braingram/Lapse-O-Matic/Lapse-O-Matic_HARDWARE/tube_trap/beambreak_brackets.stl

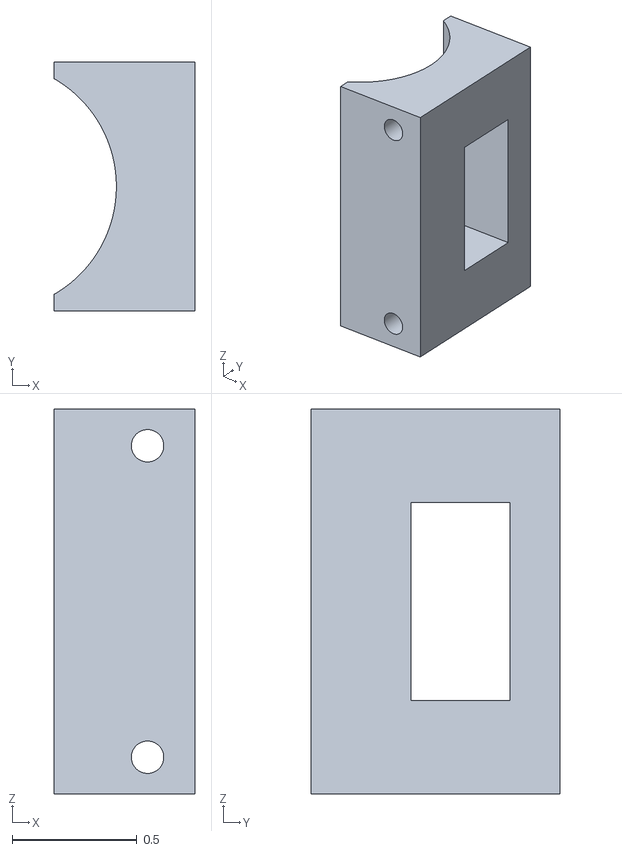
[picture p1: CAD file, 2023-06-22]
Lapse-O-Matic_HARDWARE/tube_trap/beambreak_brackets.stl
0.565 x 1.00 x 1.55
