braingram/Lapse-O-Matic/Lapse-O-Matic_PCB/Lapse_O_Matic_PCB.pdf

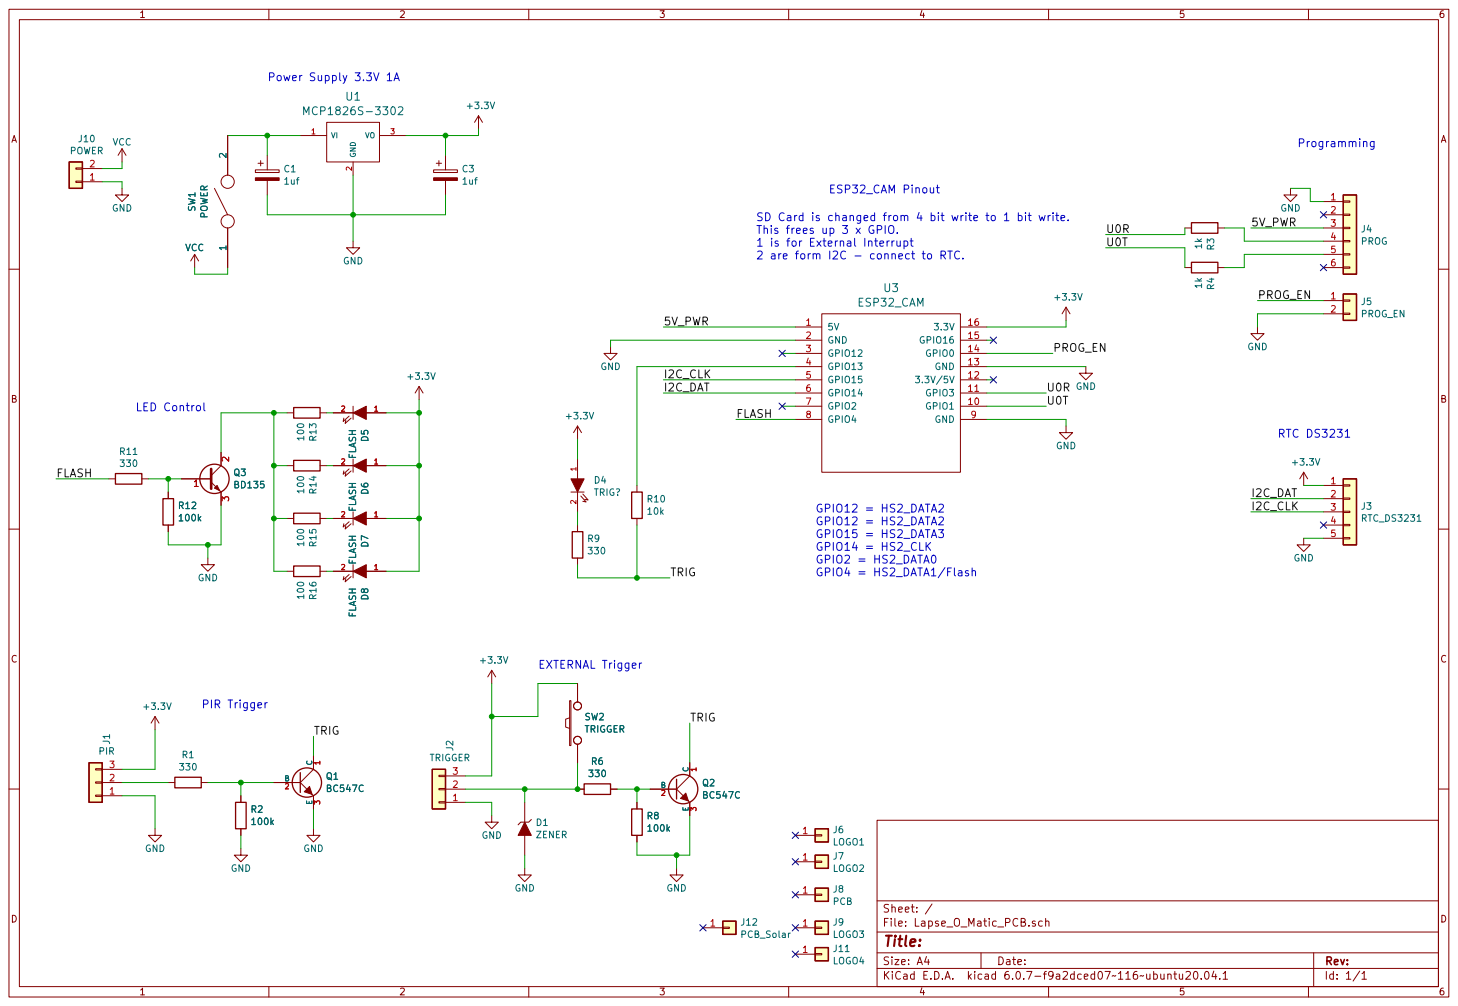
[picture p2: page 1]

I2C_CLK U0T SD Card is changed from 4 bit write to 1 bit write.
This frees up 3 x GPIO.
1 is for External Interrupt
2 are form I2C - connect to RTC.

I2C_CLK
I2C_DAT
