braingram/Lapse-O-Matic/Lapse-O-Matic_FIRMWARE/BJG_Lapse/camera_pins.h

#if defined(CAMERA_MODEL_WROVER_KIT)
#define CAM_PIN_PWDN    -1
#define CAM_PIN_RESET   -1
#define CAM_PIN_XCLK    21
#define CAM_PIN_SIOD    26
#define CAM_PIN_SIOC    27
#define CAM_PIN_D7      35
#define CAM_PIN_D6      34
#define CAM_PIN_D5      39
#define CAM_PIN_D4      36
#define CAM_PIN_D3      19
#define CAM_PIN_D2      18
#define CAM_PIN_D1       5
#define CAM_PIN_D0       4
#define CAM_PIN_VSYNC   25
#define CAM_PIN_HREF    23
#define CAM_PIN_PCLK    22


#elif defined(CAMERA_MODEL_ESP_EYE)
#define PWDN_GPIO_NUM    -1
#define RESET_GPIO_NUM   -1
#define XCLK_GPIO_NUM    4
#define SIOD_GPIO_NUM    18
#define SIOC_GPIO_NUM    23

#define Y9_GPIO_NUM      36
#define Y8_GPIO_NUM      37
#define Y7_GPIO_NUM      38
#define Y6_GPIO_NUM      39
#define Y5_GPIO_NUM      35
#define Y4_GPIO_NUM      14
#define Y3_GPIO_NUM      13
#define Y2_GPIO_NUM      34
#define VSYNC_GPIO_NUM   5
#define HREF_GPIO_NUM    27
#define PCLK_GPIO_NUM    25

#elif defined(CAMERA_MODEL_M5STACK_PSRAM)
#define PWDN_GPIO_NUM     -1
#define RESET_GPIO_NUM    15
#define XCLK_GPIO_NUM     27
#define SIOD_GPIO_NUM     25
#define SIOC_GPIO_NUM     23

#define Y9_GPIO_NUM       19
#define Y8_GPIO_NUM       36
#define Y7_GPIO_NUM       18
#define Y6_GPIO_NUM       39
#define Y5_GPIO_NUM        5
#define Y4_GPIO_NUM       34
#define Y3_GPIO_NUM       35
#define Y2_GPIO_NUM       32
#define VSYNC_GPIO_NUM    22
#define HREF_GPIO_NUM     26
#define PCLK_GPIO_NUM     21

#elif defined(CAMERA_MODEL_M5STACK_WIDE)
#define PWDN_GPIO_NUM     -1
#define RESET_GPIO_NUM    15
#define XCLK_GPIO_NUM     27
#define SIOD_GPIO_NUM     22
#define SIOC_GPIO_NUM     23

#define Y9_GPIO_NUM       19
#define Y8_GPIO_NUM       36
#define Y7_GPIO_NUM       18
#define Y6_GPIO_NUM       39
#define Y5_GPIO_NUM        5
#define Y4_GPIO_NUM       34
#define Y3_GPIO_NUM       35
#define Y2_GPIO_NUM       32
#define VSYNC_GPIO_NUM    25
#define HREF_GPIO_NUM     26
#define PCLK_GPIO_NUM     21

#elif defined(CAMERA_MODEL_AI_THINKER)
// The following defines are for the ESP32-Cam AI-THINKER module only. I haven't tried any others.
#define CAM_PIN_PWDN    32
#define CAM_PIN_RESET   -1
#define CAM_PIN_XCLK    0
#define CAM_PIN_SIOD    26
#define CAM_PIN_SIOC    27
#define CAM_PIN_D7      35
#define CAM_PIN_D6      34
#define CAM_PIN_D5      39
#define CAM_PIN_D4      36
#define CAM_PIN_D3      21
#define CAM_PIN_D2      19
#define CAM_PIN_D1      18
#define CAM_PIN_D0       5
#define CAM_PIN_VSYNC   25
#define CAM_PIN_HREF    23
#define CAM_PIN_PCLK    22

#endif
