braingram/Lapse-O-Matic/(commit log)

2023-05-15 add pdf of schematic
2023-05-22 switch to sd_mmc, add note about esp32 reset pin
2023-05-23 increase sdmmc speed, sensor resolution, decrease number of frame buffers
2023-06-22 add frame and sensor brackets for tube imaging
    [beambreak_brackets.scad, beambreak_brackets.stl]
2023-06-22 separate floor and ceiling plates
